jojorulez/Snohomish-County-Smart-Scale/ESPWiringDiagram.drawio.png

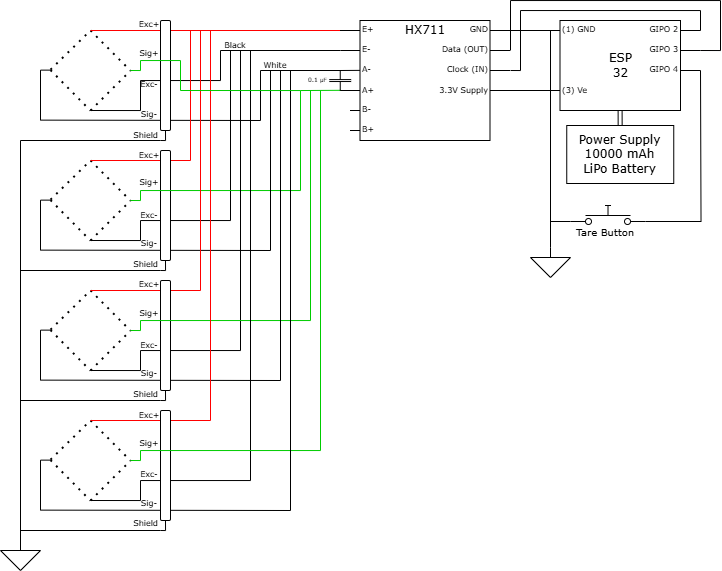
ESPWiringDiagram.drawio.png
