jojorulez/Snohomish-County-Smart-Scale/(commit log)

2025-05-26 Wiring Diagram Upload
2025-05-26 Diagnostic and Deployment C++ Sketches
    These are working programs for both assembly and diagnostics, and for field deployment. The diagnostic program shows weight in lbs, battery voltage, battery percentage, and fullness tier calculated on the OLED, and takes constant measurements. The field deployment program does not show anything on the OLED, and it takes infrequent weight measurements in order to preserve battery. Both programs transmit constant system updates via BLE advertisements.
